adafruit/Adafruit-TS3USB30-PCB/Adafruit TS3USB30 USB 1 to 2 Switch.brd

## EAGLE design Adafruit TS3USB30 USB 1 to 2 Switch.brd (2024-01-09)

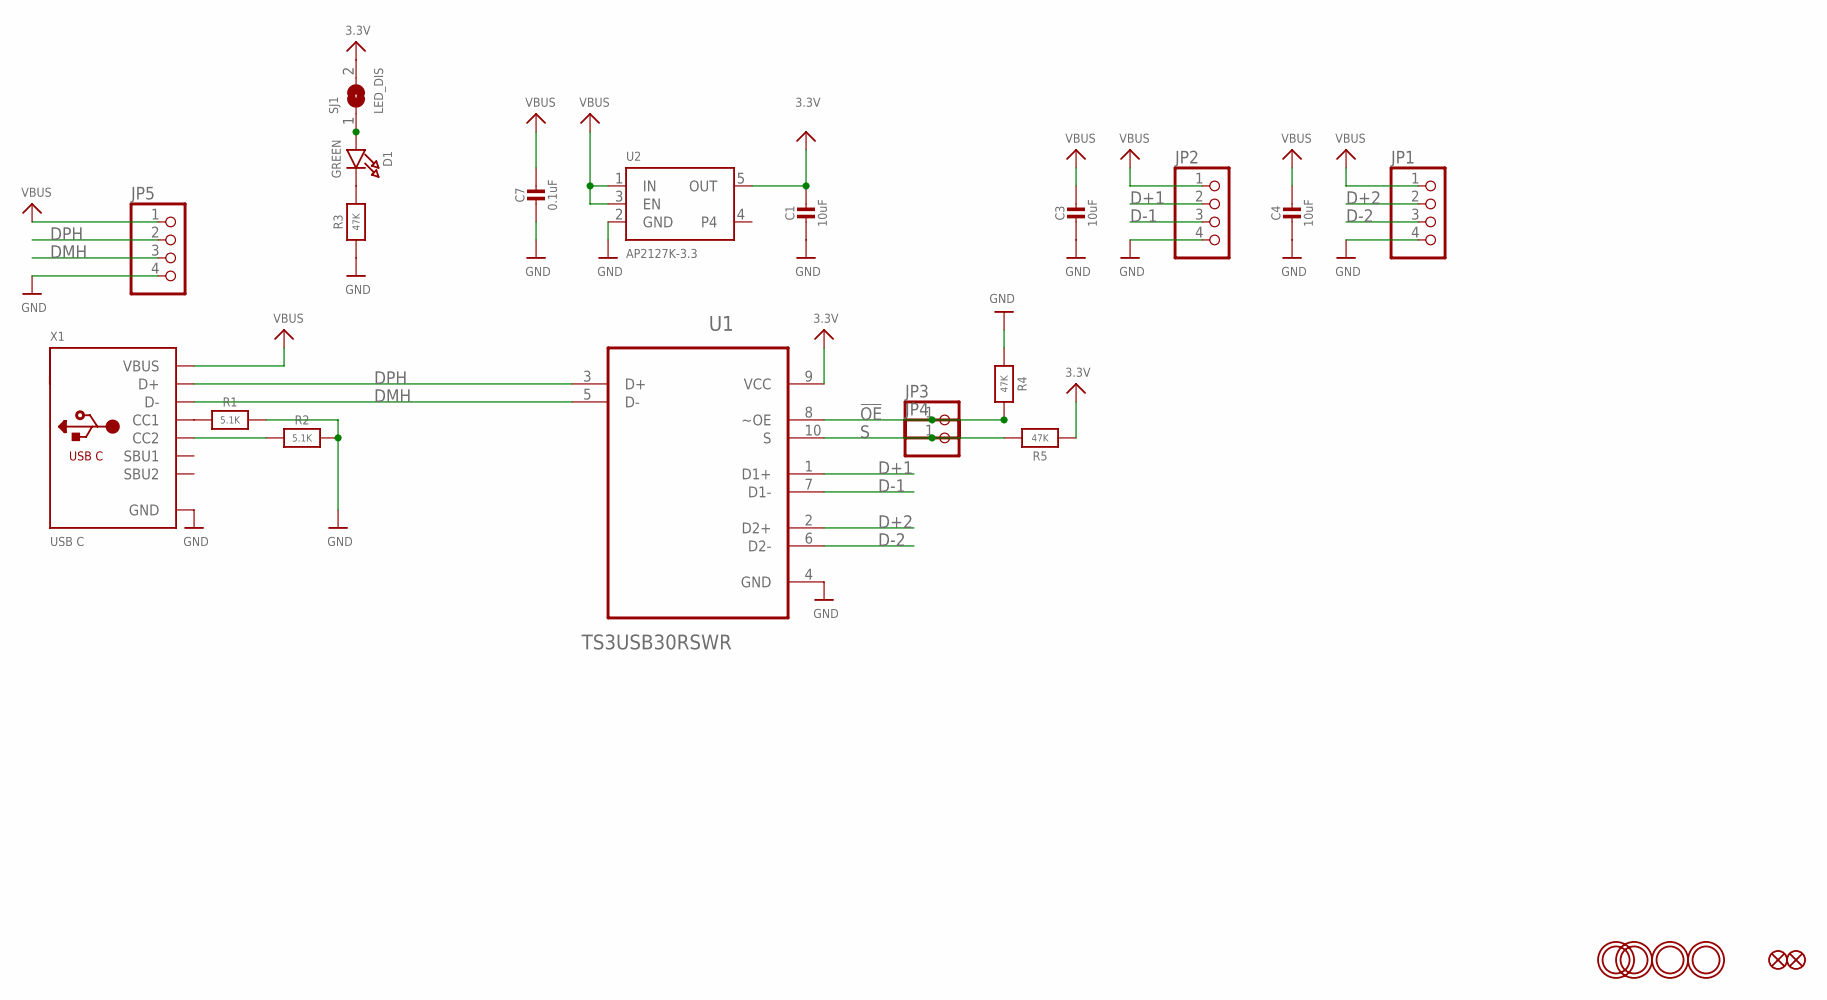
[picture p2: schematic Adafruit TS3USB30 USB 1 to 2 Switch.sch]

Parts:
C1, C3, C4: 10uF; 0805-NO
C7: 0.1uF; 0603-NO
D1: GREEN; CHIPLED_0603_NOOUTLINE
FID1, FID2: FIDUCIAL_1MM
JP1, JP2, JP5: HEADER-1X4ROUND; 1X04_ROUND
JP3, JP4: HEADER-1X1ROUND_76MIL; 1X01_ROUND_76MIL
R1, R2: 5.1K; 0603-NO
R3, R4, R5: 47K; 0603-NO
SJ1: LED_DIS; SOLDERJUMPER_CLOSEDWIRE
U1: TS3USB30RSWR; 10-UFQFN
U2: AP2127K-3.3; SOT23-5
U$23, U$28, U$29, U$31: MOUNTINGHOLE2.5; MOUNTINGHOLE_2.5_PLATED
X1: USB C; USB_C_CUSB31-CFM2AX-01-X

Connections:
3.3V: C1.1, R5.1, SJ1.2, U1.9 (VCC), U2.5 (OUT)
!OE: JP3.1, R4.2, U1.8 (~OE)
D+1: JP2.2, U1.1 (D1+)
D+2: JP1.2, U1.2 (D2+)
D-1: JP2.3, U1.7 (D1-)
D-2: JP1.3, U1.6 (D2-)
DMH: JP5.3, U1.5 (D-), X1.A7 (D-), X1.B7 (D-)
DPH: JP5.2, U1.3 (D+), X1.A6 (D+), X1.B6 (D+)
GND: C1.2, C3.2, C4.2, C7.2, JP1.4, JP2.4, JP5.4, R1.2, R2.2, R3.1, R4.1, U1.4 (GND), U2.2 (GND), X1.A1B12 (GND), X1.B1A12 (GND)
unnamed: R1.1, X1.A5 (CC1)
unnamed: R2.1, X1.B5 (CC2)
unnamed: D1.A, SJ1.1
unnamed: D1.C, R3.2
S: JP4.1, R5.2, U1.10 (S)
VBUS: C3.1, C4.1, C7.1, JP1.1, JP2.1, JP5.1, U2.1 (IN), U2.3 (EN), X1.A4B9 (VBUS), X1.B4A9 (VBUS)

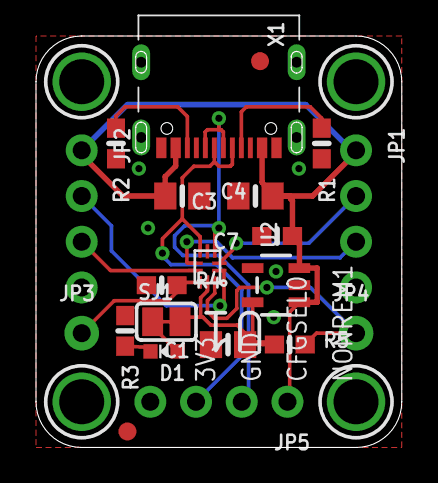
[picture p3: board Adafruit TS3USB30 USB 1 to 2 Switch.brd from above]

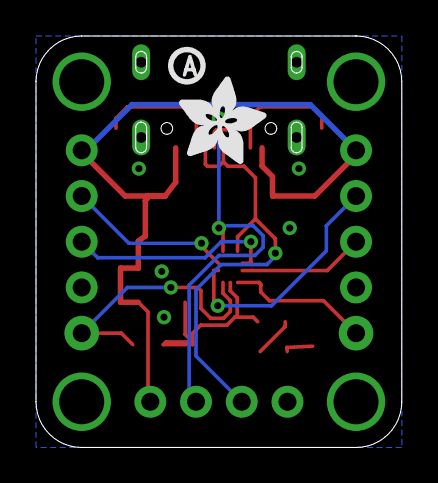
[picture p4: board Adafruit TS3USB30 USB 1 to 2 Switch.brd from below]

Board: 2 copper layers, 20.3 x 22.9 mm, 45 parts (3 on the bottom side), 15 nets.

Other parts of the board:
PLABEL0: PLABEL0
PLABEL1: PLABEL1
PLABEL2: PLABEL2
PLABEL3: PLABEL3
PLABEL4: PLABEL4
PLABEL5: PLABEL5
PLABEL6: PLABEL6
PLABEL7: PLABEL7
PLABEL8: PLABEL8
PLABEL9: PLABEL9
PLABEL10: PLABEL10
PLABEL11: PLABEL11
PLABEL12: PLABEL12
PLABEL13: PLABEL13
PLABEL14: PLABEL14
PLABEL15: PLABEL15
PLABEL16: PLABEL16
PLABEL17: PLABEL17
U$33: ADAFRUIT_5MM
U$34: PCBFEAT-REV-040
