adafruit/Adafruit-TS3USB30-PCB/(threads)

Thread 1 (2024-12-01):

Pull-up or pull-down requirements for S pin?

Andy2No, 2024-12-01:
Please document whether the S pin needs to be controlled by a double throw switch or whether it can use a pull-up or pull-down resistor to allow a single pole switch to operate it.  If a a pull-up or pull-down is an option, please document whether one is provided on the PCB, or give details of a suitable value to use.

"The S pin selects which port is active, low signal is port 1, high signal is port 2. ".

This sentence does not give the needed information.  It's taken from your readme.md page, in this repo, which was copied word for word onto the product page for this module on ThePiHut.com, and probably by others.  As consumers, that's what we get at best - a copy of what you said, which isn't sufficient, despite there being several paragraphs of text.
